jp112sdl/HB-UNI-Sen-DIST-US/(list of files, drawings)

Other design files:
Images/wiring.fzz
