jp112sdl/HB-UNI-Sen-DIST-US/(threads)

Thread 3 (2019-12-12):

3,3V Sensor

audi2010, 2019-12-12:
Hallo Jérôme,
ich nutze den RCW-0001 Ultrasonic Sensor von ebay sensus-de. Der arbeitet auch mit 3,3 V.
Sieht aus wie der Grosse , ist aber in den Abmessungen kleiner.
Vielleicht kannst du das mal ergänzen.
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

jp112sdl, 2019-12-12:
628bed010f2a1267dca3c53ee17349af79e7b16e

Closed 2019-12-12.
