jp112sdl/HB-UNI-Sen-DIST-US/(commit log)

2018-07-03 added wiring diagram
    [wiring.fzz]
2018-07-05 example with 2 sensors
2018-07-07 added sensor type selection (sr04 / maxsonar)
2018-11-10 removed printDeviceInfo()
2018-12-10 use internal bandgap reference for battery measurement
